mlindeblom/bobc_hardware/CRAMPS/CRAMPS-BOM-v1.1.xls

Item | Component | Quantity | Reference | Manufacturer | Part No. | Digikey Description | Digikey Part No | Mouser Part No
1 | BEAGLEBONE-MTG | 1 | BB101 | CircuitCo | BB-BBLK-000 | KIT DEV BEAGLEBONE BLACK REV C | BB-BBLK-000-REVC-ND | 595-BB-BBLK-000
2 | 100n | 7 | C301 C302 C501 C502 C503 C504 C505 | Murata | GRM188R71C104KA01D | CAP CER 0.1UF 16V 10% X7R 0603 | 490-1532-1-ND | 81-GRM39X104K16
3 | 10u | 4 | C506 C507 C508 C509 | Taiyo Yuden | JMK107ABJ106MAHT | CAP CER 10UF 6.3V 20% X5R 0603 | 587-3383-1-ND | 963-JMK107ABJ106MAHT
4 | 100u 35V | 7 | C201 C202 C203 C204 C205 C206 C401 | Nichicon | UCD1V101MCL6GS | CAP ALUM 100UF 35V 20% SMD | 493-6420-1-ND | 493-6420-1-ND
5 | SS14 | 6 | D401 D402 D403 D404 D405 D406 | Vishay | SS14-E3/61T | DIODE SCHOTTKY 40V 1A DO214AC | SS14-E3/61TGICT-ND | 625-SS14-E3
6 | 10A | 2 | F201 F402 | Littlefuse | 0297010.U | FUSE BLADE 10A 32V MINI FAST-AC | F6076-ND | 576-0297015.U
7 | 15A | 1 | F401 | Littlefuse | 0297015.L | FUSE BLADE 15A 32V MINI FAST-AC | F4265-ND | F4265-ND
8 | FUSE-HOLDER | 3 | FH201 FH401 FH402 | Keystone | 3568 | FUSE HOLDER BLADE 500V 20A PCB | 3568K-ND | 534-3568
9 | HEADER_3X2 (note 1) | 7 | JP201 JP202 JP203 JP204 JP205 JP206 P304 | Harwin | 534-3568 | DIL VERTICAL PC TAIL PIN HEADER | 952-2120-ND | 517-929836-01-03-RK
10 | HEADER_2X2 (note 1) | 1 | JP301 | Harwin | M20-9980245 | DIL VERTICAL PC TAIL PIN HEADER | 952-2119-ND | 517-836-01-02
11 | HEADER_2 (note 1) | 3 | JP501 P102 P103 | Harwin | M20-9990245 | SIL VERTICAL PC TAIL PIN HEADER | 952-2261-ND | 517-929836-01-01
12 | Green | 3 | LD101 LD102 LD301 | Osram | LG R971-KN-1 | LED CHIPLED 570NM GREEN 0805 SMD | 475-1410-1-ND | 720-LGR971-KN-1
13 | Red | 7 | LD302 LD401 LD402 LD403 LD404 LD405 LD406 | Osram | LH R974-LP-1 | LED CHIPLED 645NM RED DIFF 0805 | 475-1415-1-ND | 720-LHR974-LP-1
14 | BB_EXP_CONN (note 2) | 2 | P8 P9 | Major League | TSHC-123-D-06-240-GT-LF | CONN RCPT .100" 46POS DUAL TIN
15 | SOCKET_6_LONG | 1 | P101 | Sparkfun | PRT-09280 | Arduino Stackable Header - 6
16 | PT_2,5-2-5,0-H | 4 | P201 P401 P402 P403 | Phoenix | 1935776 | CONN TERM BLOCK 2POS 5.0MM | 277-6405-ND | 651-1935776
17 | KK-2.54-4W | 6 | P202 P203 P204 P205 P206 P207 | Molex | 22-23-2041 | CONN HEADER 4POS .100 VERT TIN | WM4202-ND | 538-22-23-2041
18 | POLOLU_SOCKET | 4 | P208 P209 P210 P211 | Sullins | PPTC241LFBN-RC | CONN HEADER FEMALE 24POS.1" TIN | S7022-ND
19 | KK-2.54-2W | 4 | P301 P302 P407 P409 | Molex | 22-23-2021 | CONN HEADER 2POS .100 VERT TIN | WM4200-ND | 538-22-23-2021
20 | HEADER_4X2 (note 1) | 3 | P303 P503 P504 | Harwin | M20-9980445 | DIL VERTICAL PC TAIL PIN HEADER | 952-2122-ND | 517-836-01-04
21 | HEADER_6 (note 1) | 2 | P305 P501 | Harwin | M20-9990645 | SIL VERTICAL PC TAIL PIN HEADER | 952-2269-ND | 517-929834-01-06-RK
22 | PT_1,5-3-3,5-H | 1 | P404 | Phoenix | 1984620 | CONN TERM BLOCK T/H 3POS 3.5MM | 277-1722-ND | 651-1984620
23 | PT_1,5-2-3,5-H | 3 | P405 P406 P408 | Phoenix | 1984617 | CONN TERM BLOCK T/H 2POS 3.5MM | 277-1721-ND | 651-1984617
24 | HEADER_6X2 (note 1) | 1 | P502 | Harwin | M20-9980645 | DIL VERTICAL PC TAIL PIN HEADER | 952-2125-ND | 517-929836-01-06-RK
25 | 2N7002 | 5 | Q101 Q301 Q302 Q303 Q304 | Diodes Inc. | 2N7002K-7 | MOSFET N-CH 60V 300MA SOT23-3 | 2N7002K-7DICT-ND | 621-2N7002K-7
26 | IRLB8743PBF | 4 | Q401 Q402 Q403 Q405 | IR | IRLB8743PBF | MOSFET N-CH 30V 78A TO220AB | IRLB8743PBF-ND | 942-IRLB8743PBF
27 | DMN2075U | 2 | Q404 Q406 | Diodes Inc. | DMN2075U-7 | MOSFET N-CH 20V 4.2A SOT23 | DMN2075U-7DICT-ND | 621-DMN2075U-7
28 | 220R | 7 | R305 R401 R403 R405 R407 R409 R411 | Stackpole | RMCF0603FT220R | RES 220 OHM 1/10W 1% 0603 | RMCF0603FT220RCT-ND | 660-RK73H1JTTD2200F
29 | 330R | 3 | R101 R102 R303 | Stackpole | RMCF0603FT330R | RES 330 OHM 1/10W 1% 0603 | RMCF0603FT330RCT-ND | 660-RK73H1JTTD3300F
30 | 2K0 1% | 4 | R511 R512 R513 R514 | Stackpole | RMCF0603FT2K00 | RES 2K OHM 1/10W 1% 0603 | RMCF0603FT2K00CT-ND | 660-RK73H1JTTD2001F
31 | 2K7 | 7 | R302 R402 R404 R406 R408 R410 R412 | Stackpole | RMCF0603FT2K70 | RES 2.7K OHM 1/10W 1% 0603 | RMCF0603FT2K70CT-ND | 660-RK73H1JTTD2701F
32 | 4k7 | 8 | R304 R306 R307 R314 R515 R516 R517 R518 | Stackpole | RMCF0603FT4K70 | RES 4.7K OHM 1/10W 1% 0603 | RMCF0603FT4K70CT-ND | 660-RK73H1JTTD4701F
33 | 10k | 19 | R301 R308 R309 R310 R311 R312 R313 R315 R316 R501 R502 R503 R504 R505 R506 R507 R508 R509 R510 | Stackpole | RMCF0603FT10K0 | RES 10K OHM 1/10W 1% 0603 | RMCF0603FT10K0CT-ND | 660-RK73H1JTTD1002F
34 | 100k | 6 | R201 R202 R203 R204 R205 R206 | Stackpole | RMCF0603FT100K | RES 100K OHM 1/10W 1% 0603 | RMCF0603FT100KCT-ND | 660-RK73H1JTTD1002F
35 | SHUNT | 20 | S201 S202 S203 S204 S205 S206 S207 S208 S209 S210 S211 S212 S213 S214 S215 S216 S217 S218 S301 S501 | TE | 382811-8 | SHUNT, ECON, PHBR 5AU, BLACK | A26228-ND | 571-3828118
36 | SW_PUSH | 2 | SW101 SW102 | TE | FSM2JH | SWITCH TACTILE SPST-NO 0.05A 12V | 450-1649-ND | 506-FSM2JH
37 | Pololu | 6 | U201 U202 U203 U204 U205 U206 | Pololu | 2133 | DRV8825 Stepper Motor Carrier
38 | 24C256 | 1 | U301 | On Semi | CAT24C256WI-GT3 | IC EEPROM 512KBIT 1MHZ 8SOIC | CAT24C512WI-GT3OSCT-ND | 698-CAT24C256WI-GT3
39 | 74ACT244 | 1 | U302 | Fairchild | 74ACT244SC | IC BUFF/DVR TRI-ST DUAL 20SOIC | 74ACT244SC-ND | 512-74ACT244SC
40 | 74CBTD3861 | 1 | U501 | TI | SN74CBTD3861DW | IC 10-BIT FET BUS SW 24-SOIC | 296-6486-5-ND | 595-SN74CBTD3861DWR
Note
1 | To save money on all the pin headers when buying parts for a few boards, you can get large breakaway headers
 | instead of the individual parts. You will need a total of:
 | 57 pins of single-row header
 | 74 pins of dual-row header
 | Which you can get using
 | (2) Harwin M20-9993645 36-pin single-row header
 | (2) Harwin M20-9983645 72-pin dual-row header
2 | Alternate stacking BeagleBone Headers:
 | MajorLeague SSHQ-123-D-08-GT-LF
 | Samtec SSQ-123-03-T-D (Tin)
 | Samtec SSQ-123-03-G-D (Gold)
 | Or use plain pin headers if you do not require additional expansion capes
