mlindeblom/bobc_hardware/CRAMP3/CRAMP3.kicad_pcb

## KiCad design CRAMP3/CRAMP3.kicad_pcb (2014-05-13)

Schematic: CRAMP3.sch, CRAMP3 (3-channel add-on for CRAMPS)

Parts:
C1, C2, C3: 100u 35V; c_elec_6.3x7.7; PartNo UCD1V101MCL6GS
M1, M2: 4-40; MTH_4-40; PartNo Part of PCB
P1, P2, P3: HEADER_3X2; pin_strip_3x2; PartNo M20-9980345
P4, P5, P6: KK-2.54-4W; CONN_KK_2.54_4W; PartNo 22-23-2041
P7, P8: SOCKET_4X2; Pin_Socket_4x2; PartNo PPPC042LFBN-RC
P9: SOCKET_3X2; Pin_Socket_3x2; PartNo PPPC032LFBN-RC
P10, P11: POLOLU_SOCKET; Pololu_Socket; PartNo PPTC241LFBN-RC
R1, R2, R3: 100k; RESC1608x55N; PartNo RMCF0603FT100K
S1, S2, S3, S4, S5, S6, S7, S8, S9: SHUNT; Shunt; PartNo 382811-8
U1, U2, U3: Pololu; POLOLU; PartNo DRV8825

Connections:
+3.3V: P1.1, P1.3, P1.5, P2.1, P2.3, P2.5, P3.1, P3.3, P3.5, P8.2, U1.5, U1.6, U1.10, U2.5, U2.6, U2.10, U3.5, U3.6, U3.10
+V_MOTOR: C1.1, C2.1, C3.1, P9.1, P9.3, P9.5, U1.16, U2.16, U3.16
/U1A: P4.3, U1.12
/U1B: P4.4, U1.11
/U2A: P4.2, U1.13
/U2B: P4.1, U1.14
/V1A: P5.3, U2.12
/V1B: P5.4, U2.11
/V2A: P5.2, U2.13
/V2B: P5.1, U2.14
/W1A: P6.3, U3.12
/W1B: P6.4, U3.11
/W2A: P6.2, U3.13
/W2B: P6.1, U3.14
DIR_U: P8.6, U1.8
DIR_V: P7.8, U2.8
DIR_W: P7.6, U3.8
ENAn: P8.8, U1.1, U2.1, U3.1
GND: C1.2, C2.2, C3.2, M1.1, M2.1, P7.1, P7.3, P7.5, P7.7, P8.7, P9.2, P9.4, P9.6, R1.2, R2.2, R3.2, U1.9, U1.15, U2.9, U2.15, U3.9, U3.15
unnamed: P1.6, U1.4
unnamed: P1.4, U1.3
unnamed: P3.6, U3.4
unnamed: P3.4, U3.3
unnamed: P2.6, U2.4
unnamed: P2.4, U2.3
unnamed: P2.2, R2.1, U2.2
unnamed: P1.2, R1.1, U1.2
unnamed: P3.2, R3.1, U3.2
STEP_U: P8.4, U1.7
STEP_V: P7.4, U2.7
STEP_W: P7.2, U3.7

Notes on the sheet:
24-pin Single-Row sockets for Pololus

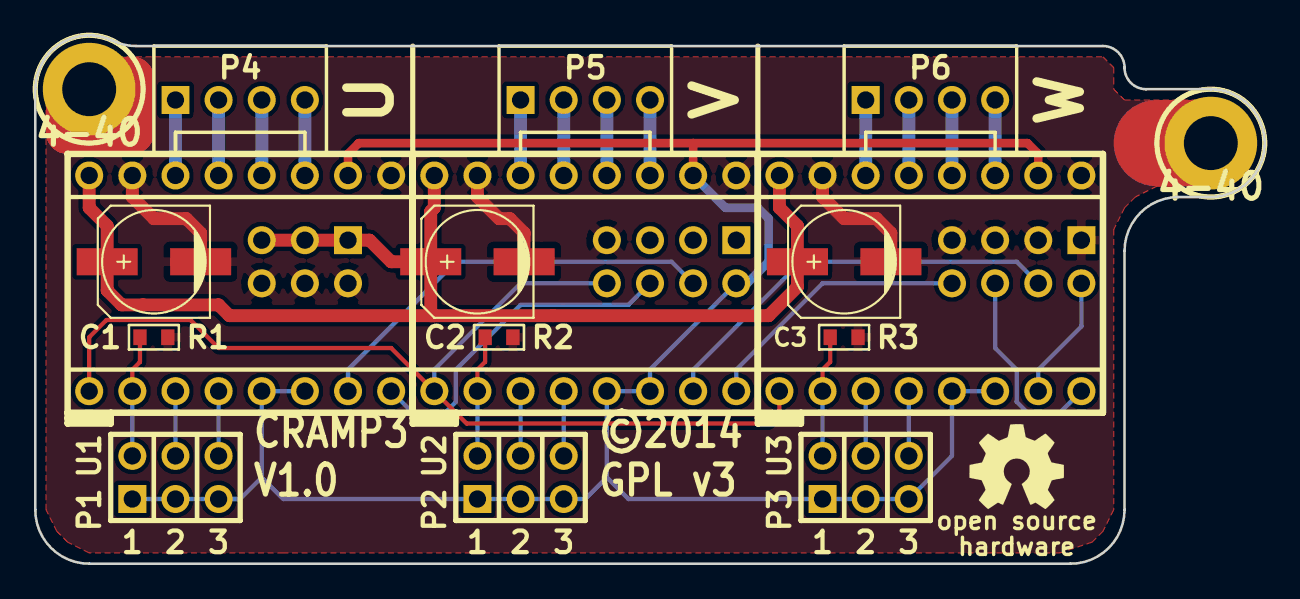
[picture p6: board CRAMP3.kicad_pcb from above]

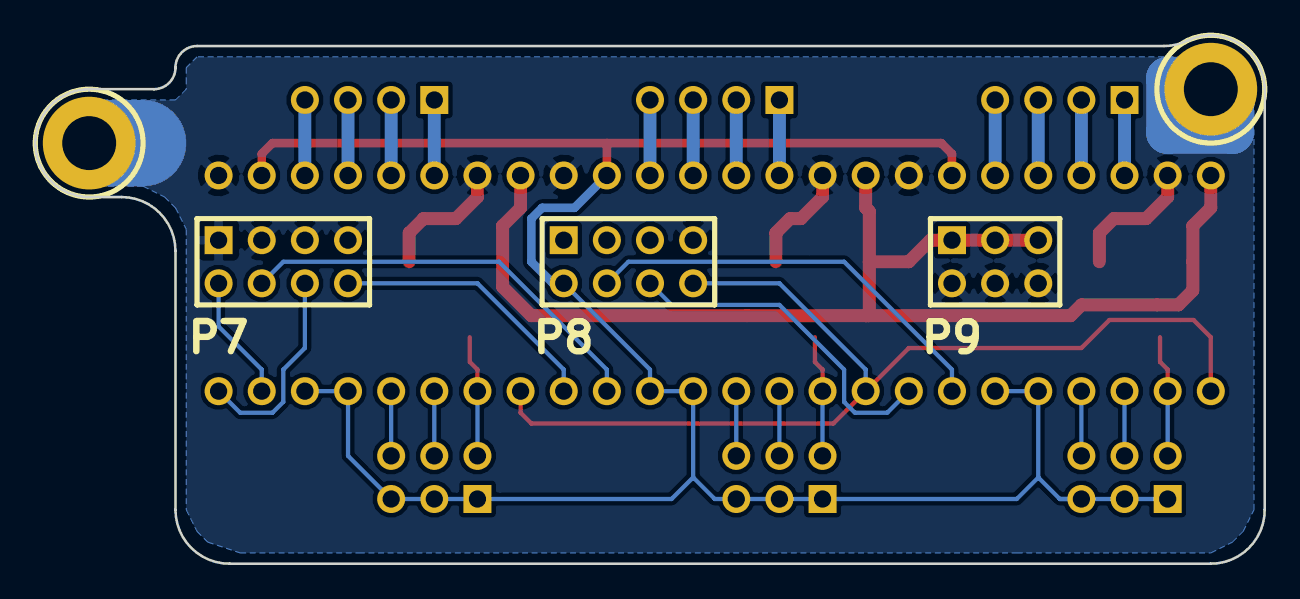
[picture p7: board CRAMP3.kicad_pcb from below]

Board: 2 copper layers, 72.4 x 31.1 mm, 32 parts (3 on the bottom side), 31 nets.

Other parts of the board:
Logo: OSHW_LOGO; OSHW_Logo_5
