mlindeblom/bobc_hardware/CRAMPS/CRAMPS.routed.kicad_pcb

## KiCad design CRAMPS/CRAMPS.routed.kicad_pcb (2014-06-01)

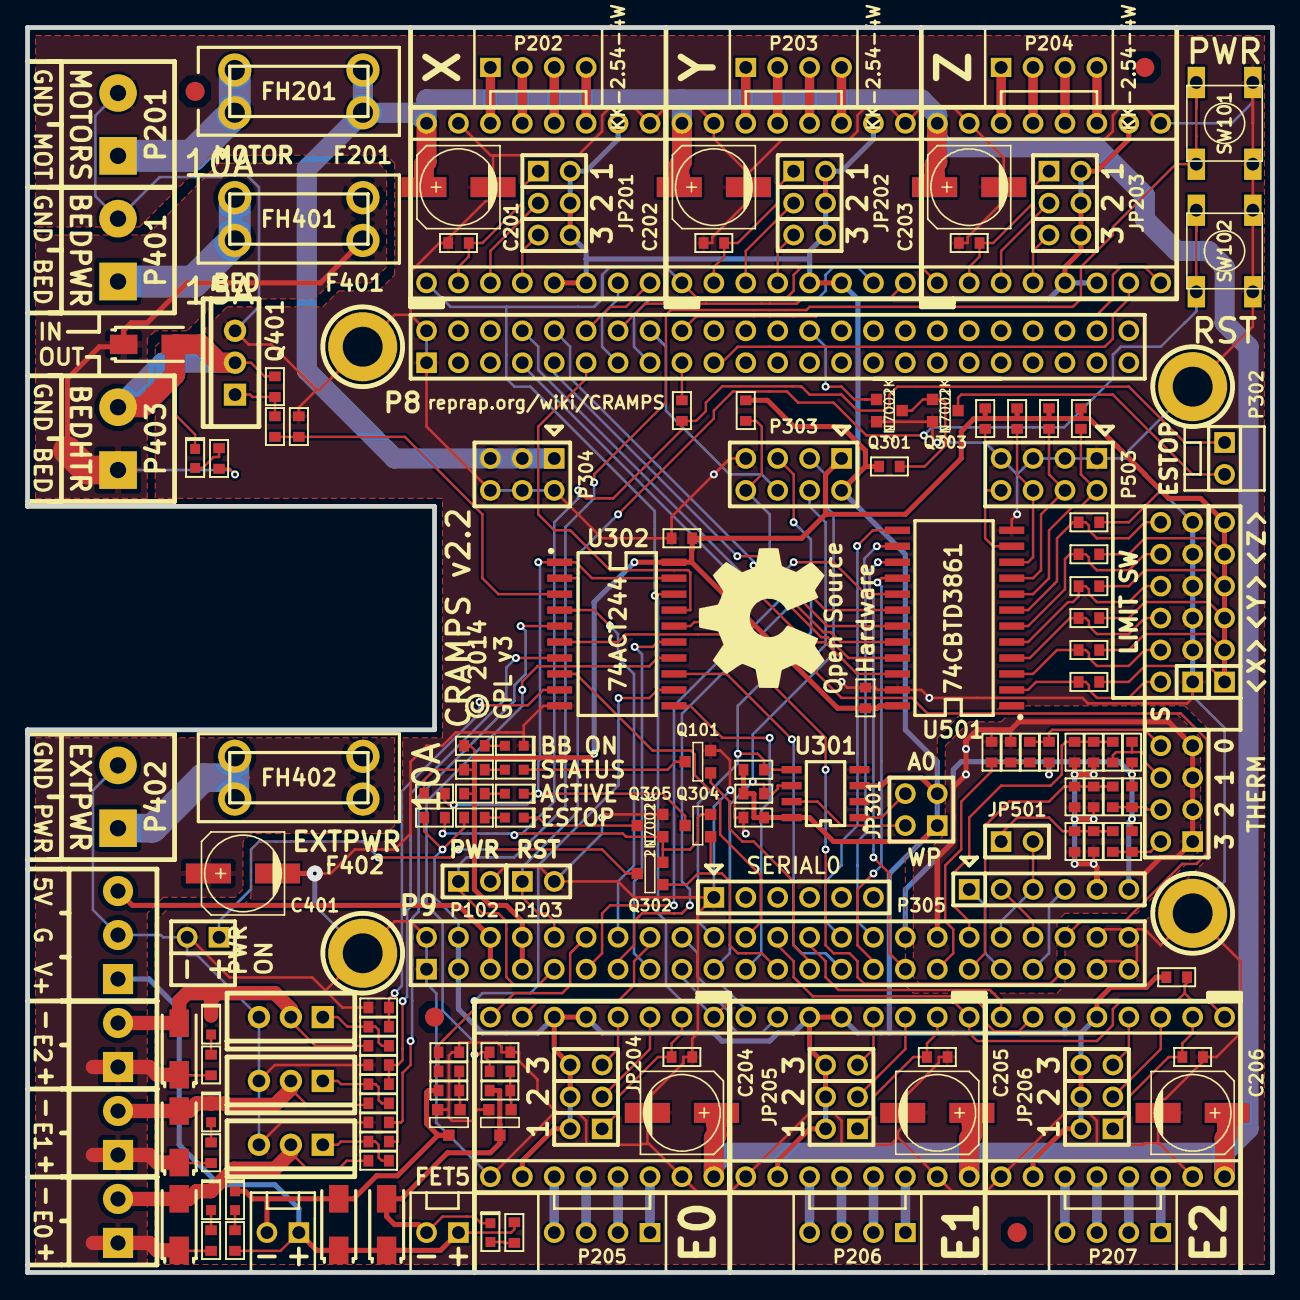
[picture p8: board CRAMPS.routed.kicad_pcb from above]

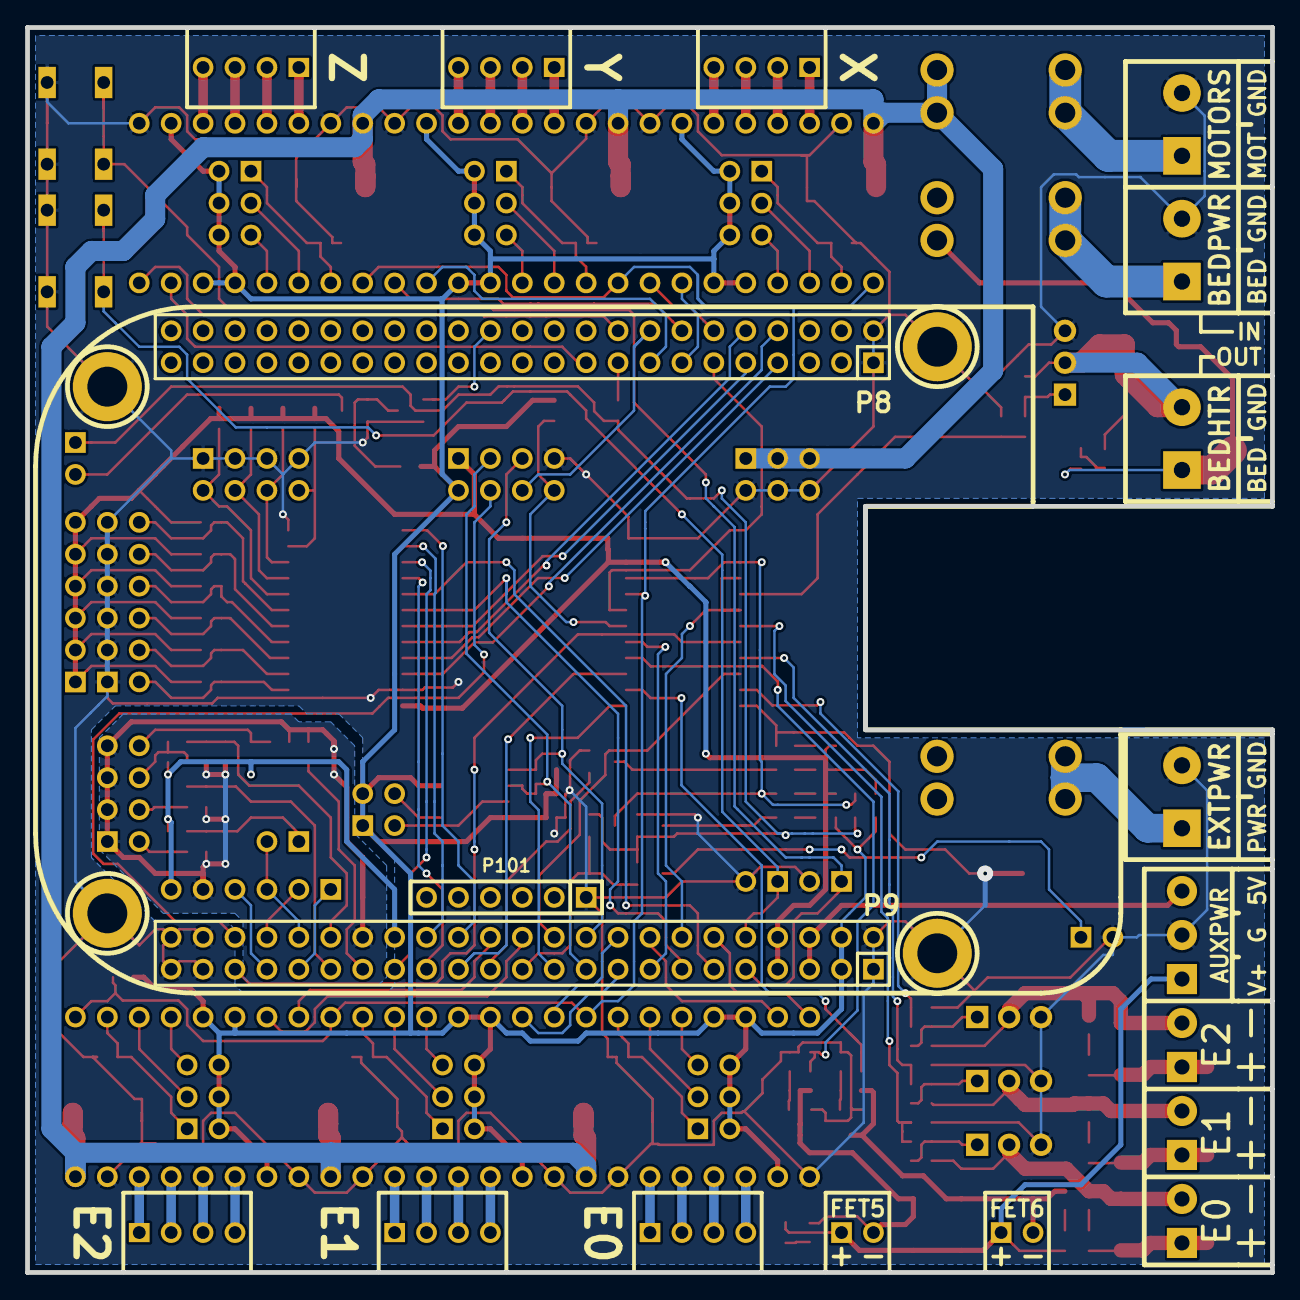
[picture p9: board CRAMPS.routed.kicad_pcb from below]

Board: 2 copper layers, 99.1 x 99.1 mm, 192 parts (4 on the bottom side), 155 nets.

Parts:
BB101: BeagleBone Black; BeagleBone-Pins
C201, C202, C203, C204, C205, C206, C401: 100u 35V; c_elec_6.3x7.7
C301, C302, C501, C502, C503, C504, C505: 100n; CAPC1608x55N
C402, C403, C404, C405, C406, C407: None; CAPC1608x55N
C506, C507, C508, C509: 10u; CAPC1608x55N
D401, D402, D403, D404, D405, D406: SS14; DIOM5127X229N
F201, F402: 10A; Fuse-Loose
F401: 15A; Fuse-Loose
FH201, FH401, FH402: FUSE-HOLDER; Keystone-3568
FID1, FID2, FID3, FID4: VAL**; FIDUCIAL-060
JP201, JP202, JP203, JP204, JP205, JP206: HEADER_3X2; pin_strip_3x2
JP301: HEADER_2X2; pin_strip_2x2
JP501: HEADER_2; pin_strip_2
LD101, LD401, LD402, LD403, LD404, LD405, LD406: Yellow; OSRAM-LED-0603
LD102, LD301: Green; OSRAM-LED-0603
LD302: Red; OSRAM-LED-0603
M101: PCB_GREEN_RMC; OSHW_logo_2
M102: LOGO_OSHW; PCB_GREEN_RMC
P8, P9: BB_EXP_CONN; P8P9_PinHeader
P101: SOCKET_6_LONG; pin_strip_6
P102, P103, P301: HEADER_2; pin_strip_2
P201, P401, P402, P403: PT_2,5-2-5,0-H
P202, P203, P204, P205, P206, P207: KK-2.54-4W; CONN_KK_2.54_4W
P208, P209, P210, P211: POLOLU_SOCKET; Pololu_Socket
P302, P407, P409: KK-2.54-2W; CONN_KK_2.54_2W
P303, P503, P504: HEADER_4X2; pin_strip_4x2
P304: HEADER_3X2; pin_strip_3x2
P305, P501: HEADER_6; pin_strip_6
P404: PT_1,5-3-3,5-H
P405, P406, P408: PT_1,5-2-3,5-H
P502: HEADER_6X2; pin_strip_6x2
Q101, Q301, Q302, Q303, Q304, Q305: 2N7002K; SOT23GDS
Q401, Q402, Q403, Q405: IRLB8743PBF; TO-220AB_IRF2804_RMC
Q404, Q406: DMN2075U; SOT23GDS
R101, R102, R303: 330R; RESC1608x55N
R201, R202, R203, R204, R205, R206: 100k; RESC1608x55N
R301, R308, R309, R310, R311, R312, R313, R315, R316, R501, R502, R503, R504, R505, R506, R507, R508, R509, R510: 10k; RESC1608x55N
R302, R402, R404, R406, R408, R410, R412: 2K7; RESC1608x55N
R304, R306, R307, R314, R515, R516, R517, R518: 4k7; RESC1608x55N
R305, R401, R403, R405, R407, R409, R411: 220R; RESC1608x55N
R511, R512, R513, R514: 2K0 1%; RESC1608x55N
S201, S202, S203, S204, S205, S206, S207, S208, S209, S210, S211, S212, S213, S214, S215, S216, S217, S218, S301, S501: SHUNT; Shunt
SW101, SW102: SW_PUSH; SW_6x6_MULTI
U201, U202, U203, U204, U205, U206: Pololu; POLOLU
U301: 24C256; SOIC127P600X175-8AN
U302: 74ACT244; SOIC127P1032X265-20N
U501: 74CBTD3861; SOIC127P1030X265-24N

Connections:
+V_MOTOR: C201.1, C202.1, C203.1, C204.1, C205.1, C206.1, FH201.3, FH201.4, P304.1, P304.3, P304.5, U201.16, U202.16, U203.16, U204.16, U205.16, U206.16
/Emergency Stop/MACHINE_PWRn: LD301.K, Q304.D, R308.2, U302.1, U302.19
/Emergency Stop/PS-On: P301.1, Q302.D
/Inputs/MISO-5V: P503.2, R507.2, U501.8
/Inputs/MOSI-5V: P503.6, R509.2, U501.10
/Inputs/SCK-5V: P503.4, R508.2, U501.9
/Inputs/SPI_CS0-5V: P503.8, R510.2, U501.11
/Mosfet Outputs/Aux_Pwr: D404.K, D406.K, P404.1, P407.1, P409.1, R408.1, R412.1
/Mosfet Outputs/Bed_Fused: D401.K, FH401.3, FH401.4, P403.1, R402.1
/Mosfet Outputs/Bed_HTR: C402.1, D401.A, LD401.K, P403.2, Q401.D
/Mosfet Outputs/Bed_Pwr: FH401.1, FH401.2, P401.1
/Mosfet Outputs/E0_HTR: C403.1, D402.A, LD402.K, P405.2, Q402.D
/Mosfet Outputs/E1_HTR: C404.1, D403.A, LD403.K, P406.2, Q403.D
/Mosfet Outputs/E2_HTR: C405.1, D405.A, LD405.K, P408.2, Q405.D
/Mosfet Outputs/Ext_Fused: C401.1, D402.K, D403.K, D405.K, FH402.3, FH402.4, P405.1, P406.1, P408.1, R404.1, R406.1, R410.1
/Mosfet Outputs/Ext_Pwr: FH402.1, FH402.2, P402.1
/Mosfet Outputs/P_FET5: C406.1, D404.A, LD404.K, P407.2, Q404.D
/Mosfet Outputs/P_FET6: C407.1, D406.A, LD406.K, P409.2, Q406.D
/Stepper Drivers/E01A: P205.3, U204.12
/Stepper Drivers/E01B: P205.4, U204.11
/Stepper Drivers/E02A: P205.2, U204.13
/Stepper Drivers/E02B: P205.1, U204.14
/Stepper Drivers/E11A: P206.3, U205.12
/Stepper Drivers/E11B: P206.4, U205.11
/Stepper Drivers/E12A: P206.2, U205.13
/Stepper Drivers/E12B: P206.1, U205.14
/Stepper Drivers/E21A: P207.3, U206.12
/Stepper Drivers/E21B: P207.4, U206.11
/Stepper Drivers/E22A: P207.2, U206.13
/Stepper Drivers/E22B: P207.1, U206.14
/Stepper Drivers/MOT_IN: FH201.1, FH201.2, P201.1
/Stepper Drivers/X1A: P202.3, U201.12
/Stepper Drivers/X1B: P202.4, U201.11
/Stepper Drivers/X2A: P202.2, U201.13
/Stepper Drivers/X2B: P202.1, U201.14
/Stepper Drivers/Y1A: P203.3, U202.12
/Stepper Drivers/Y1B: P203.4, U202.11
/Stepper Drivers/Y2A: P203.2, U202.13
/Stepper Drivers/Y2B: P203.1, U202.14
/Stepper Drivers/Z1A: P204.3, U203.12
/Stepper Drivers/Z1B: P204.4, U203.11
/Stepper Drivers/Z2A: P204.2, U203.13
/Stepper Drivers/Z2B: P204.1, U203.14
ADC_GND: C502.2, C503.2, C504.2, C505.2, C506.2, C507.2, C508.2, C509.2, P9.34, P305.5, P504.1, P504.3, P504.5, P504.7
ADC_VDD: P9.32, P305.6, R511.1, R512.1, R513.1, R514.1
AIN0: P9.39, P305.4
AIN1: P9.40, P305.2
AIN2: P9.37, P305.1
AIN3: JP501.2, P9.38, P305.3
AXIS_ENAn: P9.14, U302.2, U302.4
D3.3V: C301.1, JP201.2, JP201.4, JP201.6, JP202.2, JP202.4, JP202.6, JP203.2, JP203.4, JP203.6, JP204.2, JP204.4, JP204.6, JP205.2, JP205.4, JP205.6, JP206.2, JP206.4, JP206.6, JP301.1, JP301.3, P9.3, P9.4, P303.2, R301.1, R304.1, R305.1, R306.1, R307.1, R310.1, R314.1, U201.5, U201.6, U201.10, U202.5, U202.6, U202.10, U203.5, U203.6, U203.10, U204.5, U204.6, U204.10, U205.5, U205.6, U205.10, U206.5, U206.6, U206.10, U301.3, U301.8
DGND: BB101.M1, BB101.M2, BB101.M3, BB101.M4, C201.2, C202.2, C203.2, C204.2, C205.2, C206.2, C301.2, C302.2, C401.2, C501.2, LD102.K, P8.1, P8.2, P9.1, P9.2, P9.43, P9.44, P9.45, P9.46, P101.1, P102.2, P103.2, P201.2, P301.2, P303.7, P304.2, P304.4, P304.6, P401.2, P402.2, P404.2, P502.1, P502.3, P502.5, P502.7, P502.9, P502.11, P503.1, P503.3, P503.5, P503.7, Q101.S, Q301.S, Q303.S, Q305.S, Q401.S, Q402.S, Q403.S, Q404.S, Q405.S, Q406.S, R201.2, R202.2, R203.2, R204.2, R205.2, R206.2, R309.2, R311.2, R312.2, R313.2, R315.2, R316.2, SW101.2, SW102.2, U201.9, U201.15, U202.9, U202.15, U203.9, U203.15, U204.9, U204.15, U205.9, U205.15, U206.9, U206.15, U301.4, U302.10, U501.12, U501.23
E0_DIR: P9.12, U204.8
E0_EN_BUFn: R314.2, U201.1, U202.1, U203.1, U204.1, U205.1, U206.1, U302.18
E0_STEP: P9.16, U204.7
E1_DIR: P9.18, U205.8
E1_STEP: P9.17, U205.7
E2_DIR: P9.26, U206.8
E2_STEP: P9.24, U206.7
EN_CRAMP3n: P303.8, R310.2, U302.16
ESTOP: P8.17, R302.2
ESTOP_SW: P8.26, Q301.G
FET1: P8.11, U302.17
FET1_BUF: R309.1, R401.2, U302.3
FET2: P9.15, U302.15
FET2_BUF: R311.1, R403.2, U302.5
FET3: P9.27, U302.13
FET3_BUF: R312.1, R405.2, U302.7
FET4: P9.21, U302.11
FET4_BUF: R313.1, R409.2, U302.9
FET5: P9.41, U302.6
FET5_BUF: R316.1, R407.2, U302.14
FET6: P9.22, U302.8
FET6_BUF: R315.1, R411.2, U302.12
LED: P9.25, Q101.G
MACHINE_PWR: P9.23, Q302.G, Q304.G
MISO: P9.29, U501.16
MOSI: P9.30, U501.14
unnamed: LD102.A, R102.2
unnamed: LD101.A, R101.2
unnamed: LD101.K, Q101.D
unnamed: JP202.5, U202.4
unnamed: JP201.5, U201.4
unnamed: JP201.3, U201.3
unnamed: JP205.5, U205.4
unnamed: JP205.3, U205.3
unnamed: JP204.5, U204.4
unnamed: JP204.3, U204.3
unnamed: JP201.1, R201.1, U201.2
unnamed: JP206.3, U206.3
unnamed: JP206.5, U206.4
unnamed: JP202.1, R202.1, U202.2
unnamed: JP203.1, R203.1, U203.2
unnamed: JP205.1, R205.1, U205.2
unnamed: JP204.1, R204.1, U204.2
unnamed: JP206.1, R206.1, U206.2
unnamed: JP203.5, U203.4
unnamed: JP203.3, U203.3
unnamed: JP202.3, U202.3
unnamed: P504.4, R513.2, R517.2
unnamed: P504.8, R511.2, R515.2
unnamed: P504.2, R514.2, R518.2
unnamed: P502.4, R502.2, U501.3
unnamed: P502.6, R503.2, U501.4
unnamed: P502.8, R504.2, U501.5
unnamed: P502.10, R505.2, U501.6
unnamed: P502.12, R506.2, U501.7
unnamed: P502.2, R501.2, U501.2
unnamed: P504.6, R512.2, R516.2
unnamed: LD402.A, R404.2
unnamed: LD405.A, R410.2
unnamed: LD404.A, R408.2
unnamed: LD403.A, R406.2
unnamed: LD401.A, R402.2
unnamed: LD406.A, R412.2
unnamed: C404.2, Q403.G, R405.1
unnamed: C403.2, Q402.G, R403.1
unnamed: C407.2, Q406.G, R411.1
unnamed: C406.2, Q404.G, R407.1
unnamed: C402.2, Q401.G, R401.1
unnamed: C405.2, Q405.G, R409.1
unnamed: JP301.2, U301.7
unnamed: LD302.A, R305.2
unnamed: P302.1, Q302.S, Q304.S, Q305.G, R302.1, R304.2
unnamed: LD302.K, Q305.D
unnamed: Q301.D, Q303.G, R301.2
unnamed: P302.2, Q303.D
unnamed: LD301.A, R303.2
unnamed: JP301.4, U301.1
PWR_BUT: P9.9, P102.1, SW101.1
RESETn: P9.10, P103.1, SW102.1
SCK: P9.31, U501.15
SCL: P9.19, P303.3, R306.2, U301.6
SDA: P9.20, P303.5, R307.2, U301.5
SPI_CS0: P9.28, U501.13
SPI_CS1: P9.42, P303.4
SPI_SPARE: P8.16, P303.6
SYS_5V: C302.1, C501.1, P9.7, P9.8, P303.1, P501.1, P501.2, P501.3, P501.4, P501.5, P501.6, R101.1, R102.1, R303.1, R308.1, R501.1, R502.1, R503.1, R504.1, R505.1, R506.1, R507.1, R508.1, R509.1, R510.1, U302.20, U501.24
THERM0: C502.1, C506.1, P9.33, R515.1
THERM1: C503.1, C507.1, P9.36, R516.1
THERM2: C504.1, C508.1, P9.35, R517.1
THERM3: C505.1, C509.1, JP501.1, R518.1
VDD_5V: P9.5, P9.6, P404.3
X-MAX: P8.7, U501.21
X-MIN: P8.8, U501.22
X_DIR: P8.12, U201.8
X_STEP: P8.13, U201.7
Y-MAX: P8.9, U501.19
Y-MIN: P8.10, U501.20
Y_DIR: P8.14, U202.8
Y_STEP: P8.15, U202.7
Z-MAX: P9.11, U501.17
Z-MIN: P9.13, U501.18
Z_DIR: P8.18, U203.8
Z_STEP: P8.19, U203.7
