mlindeblom/bobc_hardware/CRAMP3/CRAMP3.sch

## KiCad design CRAMP3/CRAMP3.sch (2014-05-13)

Schematic: CRAMP3.sch

Parts:
C1, C2, C3: 100u 35V; c_elec_6.3x7.7; PartNo UCD1V101MCL6GS
M1, M2: 4-40; MTH_4-40; PartNo Part of PCB
P1, P2, P3: HEADER_3X2; pin_strip_3x2; PartNo M20-9980345
P4, P5, P6: KK-2.54-4W; CONN_KK_2.54_4W; PartNo 22-23-2041
P7, P8: SOCKET_4X2; Pin_Socket_4x2; PartNo PPPC042LFBN-RC
P9: SOCKET_3X2; Pin_Socket_3x2; PartNo PPPC032LFBN-RC
P10, P11: POLOLU_SOCKET; Pololu_Socket; PartNo PPTC241LFBN-RC
R1, R2, R3: 100k; RESC1608x55N; PartNo RMCF0603FT100K
S1, S2, S3, S4, S5, S6, S7, S8, S9: SHUNT; Shunt; PartNo 382811-8
U1, U2, U3: Pololu; POLOLU; PartNo DRV8825

Notes on the sheet:
24-pin Single-Row sockets for Pololus
