mlindeblom/bobc_hardware/CRAMPS/CRAMPS.sch

## KiCad design CRAMPS/CRAMPS.sch (2014-06-01, an earlier design)

Schematic: CRAMPS.sch

Parts:
BB101: BeagleBone Black; BeagleBone-Pins; PartNo BB-BBLK-000
LD101: Yellow; OSRAM-LED-0603; PartNo LY Q976-P1S2-36
LD102: Green; OSRAM-LED-0603; PartNo LG Q971-KN-1
M101: PCB_GREEN_RMC; OSHW_logo_2; PartNo Part of PCB
M102: LOGO_OSHW; PCB_GREEN_RMC; PartNo Part of PCB
P8, P9: BB_EXP_CONN; P8P9_PinHeader; PartNo TSHC-123-D-06-240-GT-LF
P101: SOCKET_6_LONG; pin_strip_6; PartNo PRT-09280
P102, P103: HEADER_2; pin_strip_2; PartNo M20-9990245
Q101: 2N7002K; SOT23GDS; PartNo 2N7002K-7
R101, R102: 330R; RESC1608x55N; PartNo RMCF0603FT330R
SW101, SW102: SW_PUSH; SW_6x6_MULTI; PartNo FSM2JH

Notes on the sheet:
STATUS LED
HDMI
eMMC
24.576MHz
Audio
BeagleBone serial console pass-through header
SCL1 UART1_TX
SDA1 UART1_RX
To save money on all the pin headers when buying parts for a few boards, you can get large breakaway headers instead of the individual parts. You will need a total of: 18 pins of single-row header 82 pins of dual-row header Which you can get using (1) Harwin M20-9993645 36-pin single-row header (2)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
BB ON LED
BeagleBone Logic supply is always 3.3V
SYS_5V: Low-current supply provided by BeagleBone PMIC Active when BeagleBone is running
D3.3V: Low-current supply from 500 mA LDO on BeagleBone
Serial Console
Uses Arduino 6-pin stacking connector for low-cost
Power
Reset
STEP_U
STEP_V
STEP_W
DIR_U
DIR_V
DIR_W
