mlindeblom/bobc_hardware/(commit log)

2014-05-01 Add shunt and fuse parts
    [CRAMPS.kicad_pcb, CRAMPS.sch, con_inputs.sch, con_outputs.sch, e-stop.sch, steppers.sch]
2014-05-11 Updated BOM
    [CRAMPS-BOM-v1.1.xls]
