mlindeblom/bobc_hardware/(notices)

Notices in the files:
CRAMPS/CRAMPS.kicad_pcb:
© 2014
GPL v3
